Maignot-Vicart/Arduino-Project/Répartition-des-taches.png

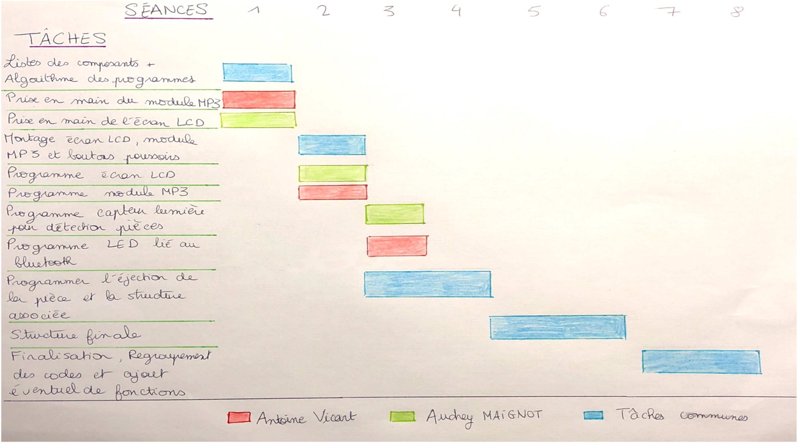
Répartition-des-taches.png
