Maignot-Vicart/Arduino-Project/Soutenance/Projet Arduino PeiP2.pptx

## Projet Arduino PeiP2

The Ultimate 80’s Jukebox

## Présentation générale

## Présentation détaillée

- Ecran LCD « Insérez une pièce »
- Capteur de distance
- Choix musique : encodeur & écran

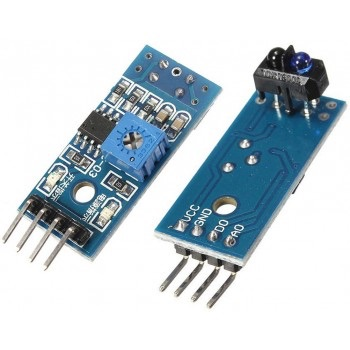
[picture p2: figure]
LOCODUINO - Réalisation pratique d&amp;#39;un système de mesure de vitesse à l&amp;#39;échelle N

## Lecture des musiques

- Module MP3 UART (carte microSD)
- Enceintes
- Réglage du volume : potentiomètre / Bluetooth

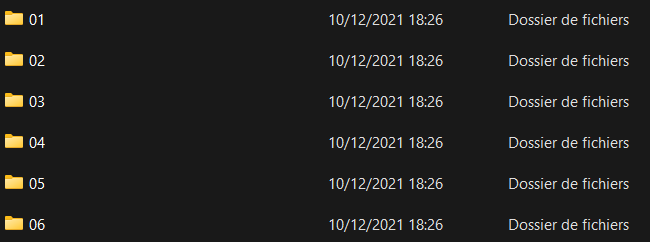
[picture p3: figure]
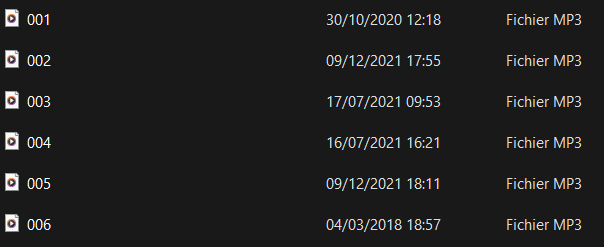
[picture p4: figure]

## Connexion RF : Bluetooth

- Réglage du volume avec son smartphone
- Module Bluetooth utilisé en cours
- Application « Bluetooth Electronics » utilisée en cours

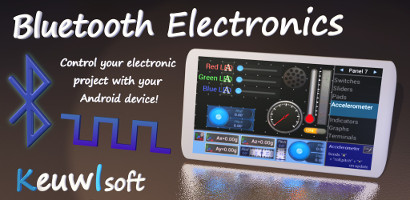
[picture p5: figure]
Bluetooth Electronics

## Guirlande LED

- Au départ : thème lumineux pour chaque genre
- Problème : codes trop volumineux
- Au final : conservation des thèmes mais lus en boucle et à la suite sur une autre carte
- Esthétisme : plastique thermoformable

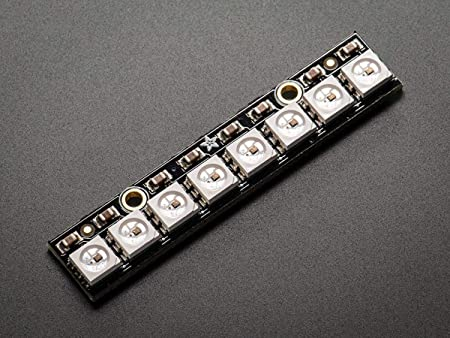
[picture p6: figure]
Adafruit NeoPixel Stick - 8 x WS2812 5050 RGB LED avec Pilotes intégrés : Amazon.fr: Informatique

## Présentation détaillée

- Ecran LCD « Fin morceau : retirez pièce »
- « Monnayeur » : boîte pouvant s’ouvrir par l’arrière de la structure

## Structure

- Bois peint en blanc
- Etages internes
- Portes arrières
- Tous les détails dans les derniers rapports de séance

## Démonstration
