Maignot-Vicart/Arduino-Project/Rapports séances/readme.md

Ce répertoire contient nos rapports individuels de séance.
