Maignot-Vicart/Arduino-Project/Programmes/readme.md

Ce répertoire contient les différents programmes de notre projet.
