Maignot-Vicart/Arduino-Project/Mémo numéro des musiques.pdf

Mémo numéro des musiques :

- ROCK : 1 :
1. Knockin’ On Heaven’s Door – Guns N’ Roses
2. Sunday Bloody Sunday – U2
3. Another One Bites the Dust – Queen
4. Rock You Like a Hurricane – Scorpions
5. Back in Black – ACDC
6. Should I Stay or Should I Go – The Clash
- POP : 2 :
1. Kiss – Prince
2. Billie Jean – Michael Jackson
3. Never Gonna Give You Up – Rick Astley
4. The Logical Song – Superstramp
5. Everybody Wants to Rule The World – Tears For Fears
6. Total Eclipse of The Heart – Bonnie Tyler
- DISCO : 3 :
1. Girls Just Wanna Have Fun – Cindy Lauper
2. Take On Me – Aha
3. I Wanna Dance with Somebody – Whitney Houston
4. Heart Of Glass – Blondie
5. Night Fever – Bee Gees
6. It’s Raining Man – Weather Girls
- 80’S MOVIES : 4 :
1. The Time of My Life – Dirty Dancing
2. Eye Of the Tiger – Rocky
3. Johnny B Goode – Back to the Future
4. Reality – La Boum
5. What A Feeling – Flashdance
6. Ghostbusters
- 80’S ARCARDE : 5 :
1. Pacman
2. Super Mario Bros
3. The Legend Of Zelda
4. Tetris
5. Metroid
6. ExciteBike
- BEST OF : 6 :
1. Purple Rain – Prince
2. Beat It – Michael Jackson
3. Radio Gaga – Queen
4. Careless Whisper – George Michael
5. The Final Countdown – Europe
6. Sweet Dreams – Annie Lenox
