Maignot-Vicart/Arduino-Project/playlist.pdf

LISTES DES MUSIQUES

ROCK | POP | DISCO | FILM | ARCADE | BEST OF
Knockin On Heaven’s Door – Guns N’ Roses | Kiss - Prince | Girls Just Wanna Have Fun-Cindy Lauper | The Time Of My Life (Dirty Dancing) | Pacman | Purple Rain - Prince
Sunday Bloody Sunday – U2 | Billie Jean - Michael Jackson | Take On Me - Aha | Eye Of the Tiger (Rocky) | Mario Bros | Michael Jackson – Beat It
Another One Bites The Dust - Queen | Never Gonna Give You Up – Rick Astley | I Wanna Dance With Somebody-Whitney Houston | Johnny B Goode – Chuck Berry (Back to the Future) | The Legend Of Zelda | Radio Gaga - Queen
Rock You Like A Hurricane -Scorpions | The Logical Song -Superstramp | Heart Of Glass-Blondie | Reality (La Boum) | Tetris | Careless Whisper – George Michael
Back In Black -ACDC | Everybody Wants To Rule The World – Tears For Fears | Night Fever-Bee Gees | What A Feeling -(FlashDance) | Metroid | The Final Countdown -Europe
Should I Stay Or Should I Go – The Clash | Total Eclipse Of The Heart – Bonnie Tyler | Weather Girls – It’s Raining Man | GhostBusters | ExciteBike | Sweet Dreams – Annie Lenox
